Anonym-tsk/smart-domofon/ge1mer/assets/domofon-back.jpg

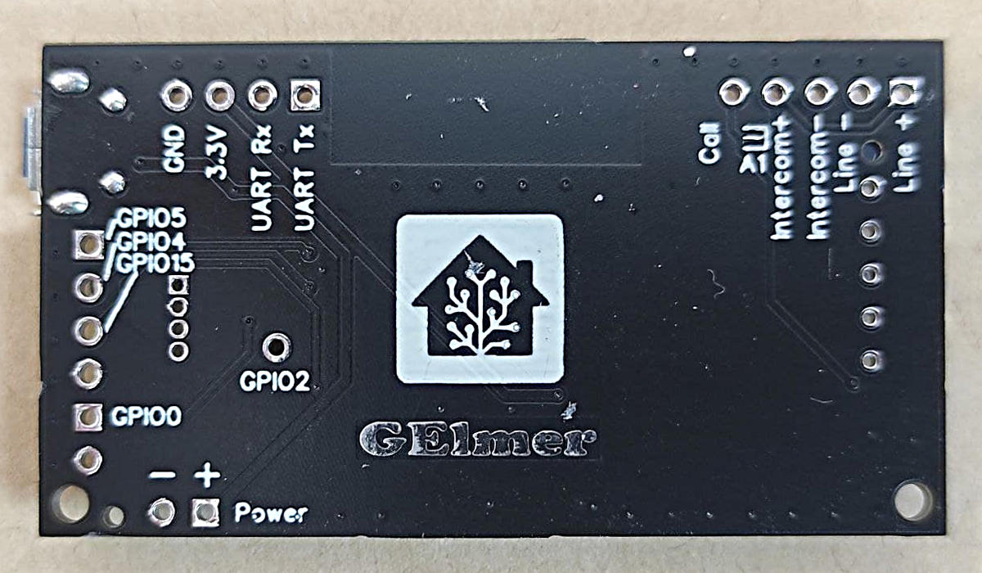
ge1mer/assets/domofon-back.jpg
