Anonym-tsk/smart-domofon/ge1mer/assets/domofon-line.jpg

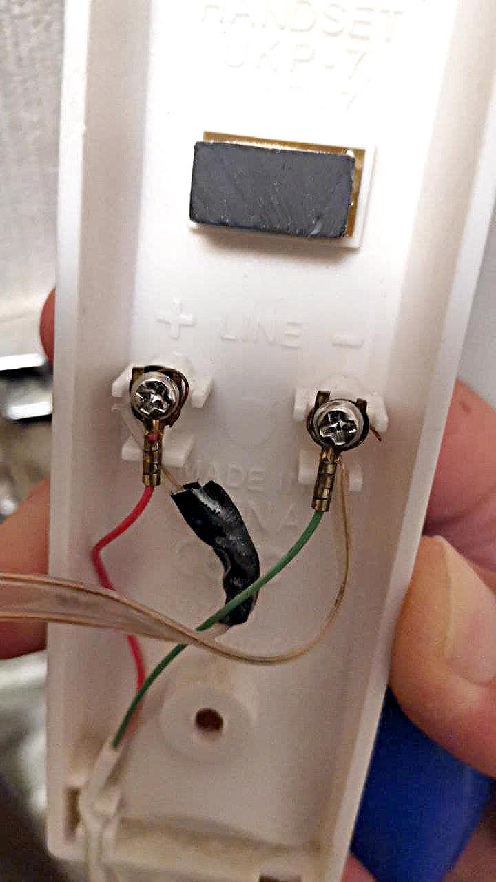
ge1mer/assets/domofon-line.jpg
