Anonym-tsk/smart-domofon/(threads)

Thread 2 (2020-09-24):

Несколько вопросов по сборке домофона

runnerfanspb, 2020-09-24:
Добрый день. Возникло несколько вопросов по сборке платы.
1. В случае когда собранная конструкция не подключена к домофону и соответственно нет входящего вызова,  при нажатии на кнопку должно ли щелкать реле?
2. На релейной плате есть перемычка, подскажите в как она должна стоять?
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

AlexSZbrn, 2020-09-24:
По первому вопросу - не скажу, не собрал ещё, а по второму - так и должна стоять, если релейный модуль питается оттуда же, откуда и контроллер.

yamaha252, 2020-09-24:
1. Нет, ведь нажатие на кнопку режимы работы переключает

runnerfanspb, 2020-09-24:
> 1. Нет, ведь нажатие на кнопку режимы работы переключает
>    https://github.com/Anonym-tsk/smart-domofon/blob/4cff7c4beba646e1ddbf7923970afd82c0444fe0/esphome/domofon.yaml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

С этим тупанул. Спасибо.

runnerfanspb, 2020-09-25:
> 1. Нет, ведь нажатие на кнопку режимы работы переключает
>    https://github.com/Anonym-tsk/smart-domofon/blob/4cff7c4beba646e1ddbf7923970afd82c0444fe0/esphome/domofon.yaml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

Хотя перечитал еще раз описание. При входящем вызову только нажатие на кнопку будет открывать дверь так не должно щелкать и открывать.
Одиночное нажатие кнопкиНет входящего вызова - включит режим автоматического открытия (открыть один раз по первому нажатию, постоянное открыти по второму)Входящий звонок - откроет дверь

yamaha252, 2020-09-25:
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

Все правильно. Если есть входящий вызов – открывает (щелкает реле несколько раз), если нет (в вашем случае) переключаются режимы по очереди (ничего не щелкает, лапочка меняет режимы)

Closed 2020-09-25.

Thread 3 (2020-09-25):

Моментальный сброс при входящем звонке

runnerfanspb, 2020-09-25:
ДОбрый день. Собрал плату. Почему то при входящем звонке происходит моментальный сброс звонка, даже не успеваешь ответить. Хотя в телегу приходит сообщение открыть или отклонить. Как увеличить время ответа? А то домофон начинает после секунды сигнала переходить в error

runnerfanspb, 2020-09-25:
Звонок стал проходить, но вот дверь не открывается. Ранее открывалась дверь при авто открытии, или же одиночном открытии. С чем может быть связано?

yamaha252, 2020-09-25:
Может быть связано с настройками таймингов тут
https://github.com/Anonym-tsk/smart-domofon/blob/4cff7c4beba646e1ddbf7923970afd82c0444fe0/esphome/domofon.yaml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

У каждого домофона свои особенности, например мой метаком, не отрабатывает открытие двери, если оно происходит в момент, когда звенит уличный блок 🙂

yamaha252, 2020-09-25:
Кстати, вот это время `call_end_detect_delay` должно быть не меньше суммы всех задержек указанных ниже. Иначе, если включено автоматическое открытие, не успеют закончится все операции при первом цикле входящего звонка, запустится повторный цикл и опять начнет молотить тоже самое паралельно.

runnerfanspb, 2020-09-26:
> Кстати, вот это время `call_end_detect_delay` должно быть не меньше суммы всех задержек указанных ниже с префиксом `relay_`. Иначе, если включено автоматическое открытие, не успеют закончится все операции при первом цикле входящего звонка, запустится повторный цикл и опять начнет молотить тоже самое паралельно.

Решил попробовать последовать вашему совету. А дальше будет видно
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

runnerfanspb, 2020-09-26:
не работает. вообще перестал открывать. а где можно посмотреть особенности визита? и может быть проблема, что собирал по схеме, а трубку не ставил перед домофоном,?

runnerfanspb, 2020-09-26:
Нашел ошибку, т. К. Трубки нет. Надо было резистор поставить

yamaha252, 2020-12-04:
Нельзя ставить резистор, оно может повлиять на работу всей домофонной сети.

Anonym-tsk, 2020-12-04:
> Нельзя ставить резистор, оно может повлиять на работу всей домофонной сети.

Трубка даёт сопротивление 50 Ом в линию. Её смело можно заменить на резистор такого же номинала

yamaha252, 2020-12-04:
> Трубка даёт сопротивление 50 Ом в линию. Её смело можно заменить на резистор такого же номинала
Это я на собственном опыте проверил, поставил резитор и все звонки по подъезду начали идти в последнюю квартиру :)
Возможно связано с тем, что сопротивление в трубке появляется только при поступлении питания на линии, а не всегда.

Anonym-tsk, 2020-12-04:
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

Сопротивление в трубке есть всегда. По нему вызывная панель определяет подключена ли трубка.
Вы явно что-то сделали не так

yamaha252, 2020-12-08:
Специалисты сказали, что замыкать линию нельзя. Может зависит от разводки в каждом конкретном случае.
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

Closed 2020-09-26.

Thread 4 (2021-01-24):

перестали приходить сообщения в телеграмм

runnerfanspb, 2021-01-24:
почему то перестали приходить сообщения в телегу при разовом открытии, при автоматическом открытии. При звонке просто сообщение приходит с предложением открыть или отклонить. при открытии с кнопки так же.

runnerfanspb, 2021-01-24:
в настройках ничего не менял

Anonym-tsk, 2022-07-25:
Проверить автоматизации в ХА

Closed 2022-07-25.

Thread 12 (2021-12-09):

Ошибка при компиляции в EspHome Addon HA

lotohov, 2021-12-09:
INFO Reading configuration /config/esphome/domofon.yaml...
Failed config

esp8266: None
  restore_from_flash: True
  board_flash_mode: dout

  Framework version needs to be explicitly specified when custom source is used.
  framework:  None
    source: platformio/espressif8266@2.6.2
  board: esp12e

Closed 2021-12-09.

Thread 13 (2022-07-22):

Генерировать событие при открытии двери

gorbunovav, 2022-07-22:
День добрый!

В сценариях автоматизации бывает необходимо реагировать на открытие двери домофоном.
Можно отслеживать изменения статусов, но это представляет не очень надежным + есть разные последовательности смены статусов.

В ESPHome есть возможность генерировать события в Home Assistant. На мой взгляд было бы удобно отправлять такое событие при выполнении действия открытия.

Anonym-tsk, 2022-07-25:
Пришлось откатить. Не работает с mqtt.
Если будет идея как сделать универсально - добавим.

gorbunovav, 2022-07-30:
@Anonym-tsk  сделал через вызов скриптов отправки событий, варианты которых определены в `api.yaml` и в `mqtt.yaml` с соответствующей реализацией.

Anonym-tsk, 2022-09-09:
В последней прошивке добавлен сенсор `Domofon Action`. Подробнее в Readme

Closed 2022-09-09.

Thread 16 (2023-12-21):

2023.12 pin reuse validation

odddim0n, 2023-12-21:
После обновления ESPHome до версии 2023.12 не компилируется конфиг, не проходит валидацию переиспользования пинов (https://esphome.io/changelog/2023.12.0.html). Проблема с $pin_led_blue, который определён как Status LED в light.yaml, а также как led_blue в output.yaml.
"The error can be bypassed by specifically adding another config item to all of the duplicate pin definitions": переменная allow_other_uses (Optional, boolean)

Anonym-tsk, 2023-12-21:
Исправлено

Closed 2023-12-21.

Thread 18 (2023-12-29):

Не компилится конфиг

Mioze, 2023-12-29:
Похоже обновления ESP не дают компилится конфигу
INFO ESPHome 2023.12.5
INFO Reading configuration /config/esphome/domofon.yaml...
Failed config

switch.template: [source <unicode string>:237]
  platform: template
  name: Domofon automatically open
  id: auto_open
  icon: mdi:door-open
  optimistic: True

  The restore_state option has been removed in 2023.7.0. Use the restore_mode option instead.
  restore_state: True
  on_turn_on:
    - switch.turn_off: auto_open_once
    - switch.turn_off: auto_reject
    - script.execute: state_no_call
  on_turn_off:
    script.execute: state_no_call
switch.template: [source <unicode string>:251]
  platform: template
  name: Domofon automatically open once
  id: auto_open_once
  icon: mdi:door-open
  optimistic: True

  The restore_state option has been removed in 2023.7.0. Use the restore_mode option instead.
  restore_state: True
  on_turn_on:
    - switch.turn_off: auto_open
    - switch.turn_off: auto_reject
    - script.execute: state_no_call
  on_turn_off:
    script.execute: state_no_call
switch.template: [source <unicode string>:265]
  platform: template
  name: Domofon automatically reject
  id: auto_reject
  icon: mdi:door-closed-lock
  optimistic: True

  The restore_state option has been removed in 2023.7.0. Use the restore_mode option instead.
  restore_state: True
  on_turn_on:
    - switch.turn_off: auto_open
    - switch.turn_off: auto_open_once
    - script.execute: state_no_call
  on_turn_off:
    script.execute: state_no_call

Anonym-tsk, 2023-12-30:
У вас очень старая прошивка. Обновитесь.

Mioze, 2023-12-30:
Получается это у Вас конфиг устаревший
В этих разделах:
# Automatically open door switch
# Automatically open door once switch
# Automatically reject call switch
поменял с:    restore_state: true
на: restore_mode: ALWAYS_ON
только тогда конфиг залетел в esp
нововведение Esphome в home assistant...

Anonym-tsk, 2023-12-30:
Вы видимо используете прошивку из каталога esphome. Она давно не поддерживается, но я внесу изменения. Спасибо.

19leva89, 2024-07-02:
День добрый, можете помочь? Не компилируется(

```
INFO ESPHome 2024.6.4
INFO Reading configuration /config/esphome/domofon.yaml...
INFO Cloning https://github.com/Anonym-tsk/smart-domofon.git@master
INFO Fetching master
Failed config

ota.unknown: [source /data/packages/2ae9eeeb/ge1mer/esphome/packages/base.yaml:35]

  'ota' requires a 'platform' key but it was not specified.
  password: esphome
```

Anonym-tsk, 2024-07-02:
> можете помочь?

Внес исправления в код.
Удалите каталог `/config/.esphome/packages` перед сборкой, должно заработать.

19leva89, 2024-07-03:
Да все ок, спасибо!

> > можете помочь?
>
> Внес исправления в код. Удалите каталог `/config/.esphome/packages` перед сборкой, должно заработать.

Closed 2024-07-02.

Thread 19 (2024-10-22):

Ошибка обновления ESPHome 2024.10.1

odddim0n, 2024-10-22:
Ошибка при попытке обновления до ESPHome 2024.10.1. Журнал обновления:
Compiling .pioenvs/domofon/src/main.cpp.o
<command-line>: warning: "MMU_IRAM_SIZE" redefined
<command-line>: note: this is the location of the previous definition
<command-line>: warning: "MMU_ICACHE_SIZE" redefined
<command-line>: note: this is the location of the previous definition
Compiling .pioenvs/domofon/FrameworkArduino/umm_malloc/umm_malloc.cpp.o
<command-line>: warning: "MMU_IRAM_SIZE" redefined
<command-line>: note: this is the location of the previous definition
<command-line>: warning: "MMU_ICACHE_SIZE" redefined
<command-line>: note: this is the location of the previous definition
/data/cache/platformio/packages/framework-arduinoespressif8266/cores/esp8266/umm_malloc/umm_malloc.cpp: In function 'void umm_init_iram()':
/data/cache/platformio/packages/framework-arduinoespressif8266/cores/esp8266/umm_malloc/umm_malloc.cpp:593:22: error: 'mmu_sec_heap' was not declared in this scope
  593 |     umm_init_iram_ex(mmu_sec_heap(), mmu_sec_heap_size(), true);
      |                      ^~~~~~~~~~~~
/data/cache/platformio/packages/framework-arduinoespressif8266/cores/esp8266/umm_malloc/umm_malloc.cpp:593:38: error: 'mmu_sec_heap_size' was not declared in this scope; did you mean 'umm_free_heap_size'?
  593 |     umm_init_iram_ex(mmu_sec_heap(), mmu_sec_heap_size(), true);
      |                                      ^~~~~~~~~~~~~~~~~
      |                                      umm_free_heap_size
*** [.pioenvs/domofon/FrameworkArduino/umm_malloc/umm_malloc.cpp.o] Error 1
========================= [FAILED] Took 14.89 seconds =========================

Alexamig, 2024-10-22:
Попробуйте так сделать:
  platformio_options:
    build_flags: -DBEARSSL_SSL_BASIC -DMMU_IRAM_SIZE=0xC000 -DMMU_ICACHE_SIZE=0x4000 -DMMU_IRAM_HEAP
на
  platformio_options:
    build_flags: -DBEARSSL_SSL_BASIC -DMMU_IRAM_SIZE=0xC000 -DMMU_ICACHE_SIZE=0x4000 -D PIO_FRAMEWORK_ARDUINO_MMU_CUSTOM
и все пойдет

odddim0n, 2024-10-23:
Спасибо!
Если у кого-то аналогичная ситуация: base.yaml - это часть репозитория, поэтому проще в конфиге устройства в ESPHome (domofon.yaml) в раздел esphome: добавить по аналогии с base.yaml замену
  platformio_options:
    build_flags: -DBEARSSL_SSL_BASIC -DMMU_IRAM_SIZE=0xC000 -DMMU_ICACHE_SIZE=0x4000 -D PIO_FRAMEWORK_ARDUINO_MMU_CUSTOM

eratnik, 2024-11-14:
> Попробуйте так сделать в base.yaml: platformio_options: build_flags: -DBEARSSL_SSL_BASIC -DMMU_IRAM_SIZE=0xC000 -DMMU_ICACHE_SIZE=0x4000 -DMMU_IRAM_HEAP на platformio_options: build_flags: -DBEARSSL_SSL_BASIC -DMMU_IRAM_SIZE=0xC000 -DMMU_ICACHE_SIZE=0x4000 -D PIO_FRAMEWORK_ARDUINO_MMU_CUSTOM и все пойдет

Спасибо, ваш совет помог, но не полностью - не работает беззвучный режим. Оно пытается переключать, лампочка пару раз моргает, но выключается, а в логах пишет:
```
[20:11:02][W][component:237]: Component preferences took a long time for an operation (108 ms).
[20:11:02][W][component:238]: Components should block for at most 30 ms.
```
Остальные режимы вроде работают, автооткрытие точно.
Может есть мысли, чем можно помочь? На предыдущей версии ESPhome все работало

Alexamig, 2024-11-15:
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
Да есть такое что-то неправильно стало работать)) Заметил, что uptime стал часто сбрасываться. Я автоматизацией с 12 ночи ставлю без звука режим и заметил что он постоянно стал скидываться на простой и uptime заново с 0 отсчитывает.
Убрал лишний мусор и все нормализовалось, работает на всех режимах отлично.
В base.yaml
esphome:
  name: $mdns_name
  # build_path: $build_path
  platform: ESP8266
  board: $board
  comment: "espdomofon.ru"
  esp8266_restore_from_flash: true
  project:
    name: "espdomofon.ru"
    version: "1.6.2"
  # platformio_options:
  #   build_flags: -DBEARSSL_SSL_BASIC -DMMU_IRAM_SIZE=0xC000 -DMMU_ICACHE_SIZE=0x4000 -D PIO_FRAMEWORK_ARDUINO_MMU_CUSTOM
  on_boot:
    priority: 600
    then:
      - script.execute: state_ready
      - light.turn_on:
          id: rgb_led
          effect: "Domofon"

Thread 20 (2025-01-27):

Громкий писк на вызывной панели

Eugen4, 2025-01-27:
Добрый день. Собрал схему, начал тестирование.
Логика работает (домофон открывает дверь), но есть одна проблема: с момента переключения 1 реле до переключения 2 реле (активирован резистор на 330) со стороны вызывной панели на улице звучит громкий писк.
Кто-то сталкивался с подобным? Как решить?

maxx69rus, 2025-01-27:
Да, пищит как бешеный, я вроде тайминги-задержки какие-то пытался крутить, но или не помогло или после обновления затерлось.

Thread 21 (2025-02-20):

Обновление platform для ESPHome 2025.2

odddim0n, 2025-02-20:
https://github.com/esphome/esphome/pull/8118
В новой версии ESPHome раздел platform переехал. Обновление не компилится.

Please remove the `platform` key from the [esphome] block and use the correct platform component. This style of configuration has now been removed.

  platform: ESP8266
  board: esp12e
  comment: espdomofon.ru
  esp8266_restore_from_flash: True

Closed 2025-04-15.
