Anonym-tsk/smart-domofon/native/src/config/hardware.h

#ifndef HW_H_
#define HW_H_

// Hardware configuration
#define PIN_RELAY_ANSWER      16  //D0
#define PIN_RELAY_DOOR_OPEN   5   //D1

#define PIN_LED_RED           4   //D2
#define PIN_LED_GREEN         0   //D3
#define PIN_LED_BLUE          2   //D4

#define PIN_CALL_DETECT       14  //D5

#define PIN_BUTTON_GREEN      12  //D6
#define PIN_BUTTON_RED        13  //D7

#endif // HW_H_
