Anonym-tsk/smart-domofon/(commit log)

2019-10-29 Перевод readme
2019-10-31 Reject calls switch
2019-10-31 Leds fix
2019-11-02 Fix button
2020-11-24 Fixed telegram for HA 0.118
    [domofon.yaml]
2021-02-09 Gelmer board
2021-02-11 device_class: sound
2021-02-12 Accept/Reject call switches
2021-03-21 Delete board.jpeg
    will be replaced with new image
2021-03-21 Update README.md
    change absolute paths to relative, renew board image, add some text
2021-03-24 readme: Монтаж в разрыв линии
    уточнения
2021-03-24 Update Readme.md
    Две орфографические правки ;-)
2021-03-25 led_brightness moved to vars
2021-03-31 Home Assistant fix for domofon_automatically_reject
    [domofon.yaml]
2021-09-20 Fix push-button behavior
2021-10-15 LED brightness
2021-10-15 Fixed status led and mute led color
2021-10-15 Leds new logic
2021-10-15 Leds blink fix
2022-02-15 Open / Reject buttons
2022-07-25 Пока отключил homeassistant.event - не работает с MQTT
2022-09-09 call_start_detect_delay fix & action sensor
2022-09-12 Leds inversion support
2022-09-23 Safe Mode button added
2022-10-28 Fixed led when not connected to wifi. Added 8 clicks action.
2023-12-21 Fix pin reuse for ESPHome 2023.12
    [domofon.yaml]
2024-07-02 ota fix for latest esphome
    [domofon.yaml]
2026-02-08 Update mqtt.yaml
    mqtt devices discovery on (true)
